MarvinBrth/ttsky25b-analog-opamp-rrio-cgm/docs/images/bias-supply.png

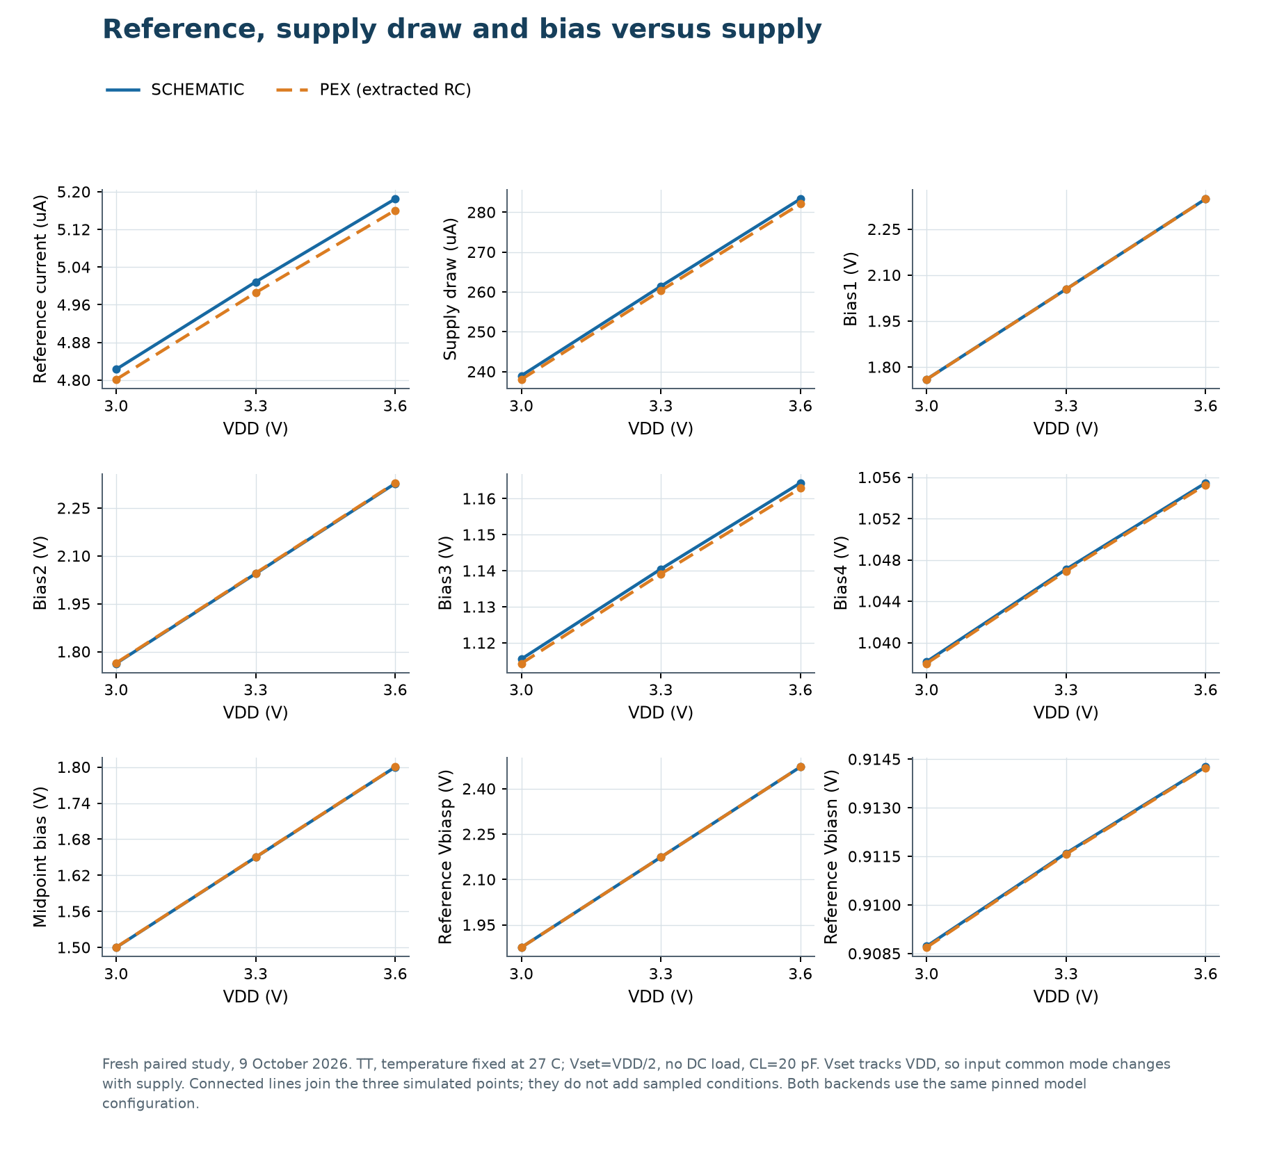
docs/images/bias-supply.png
