MarvinBrth/ttsky25b-analog-opamp-rrio-cgm/docs/images/bias-temperature.png

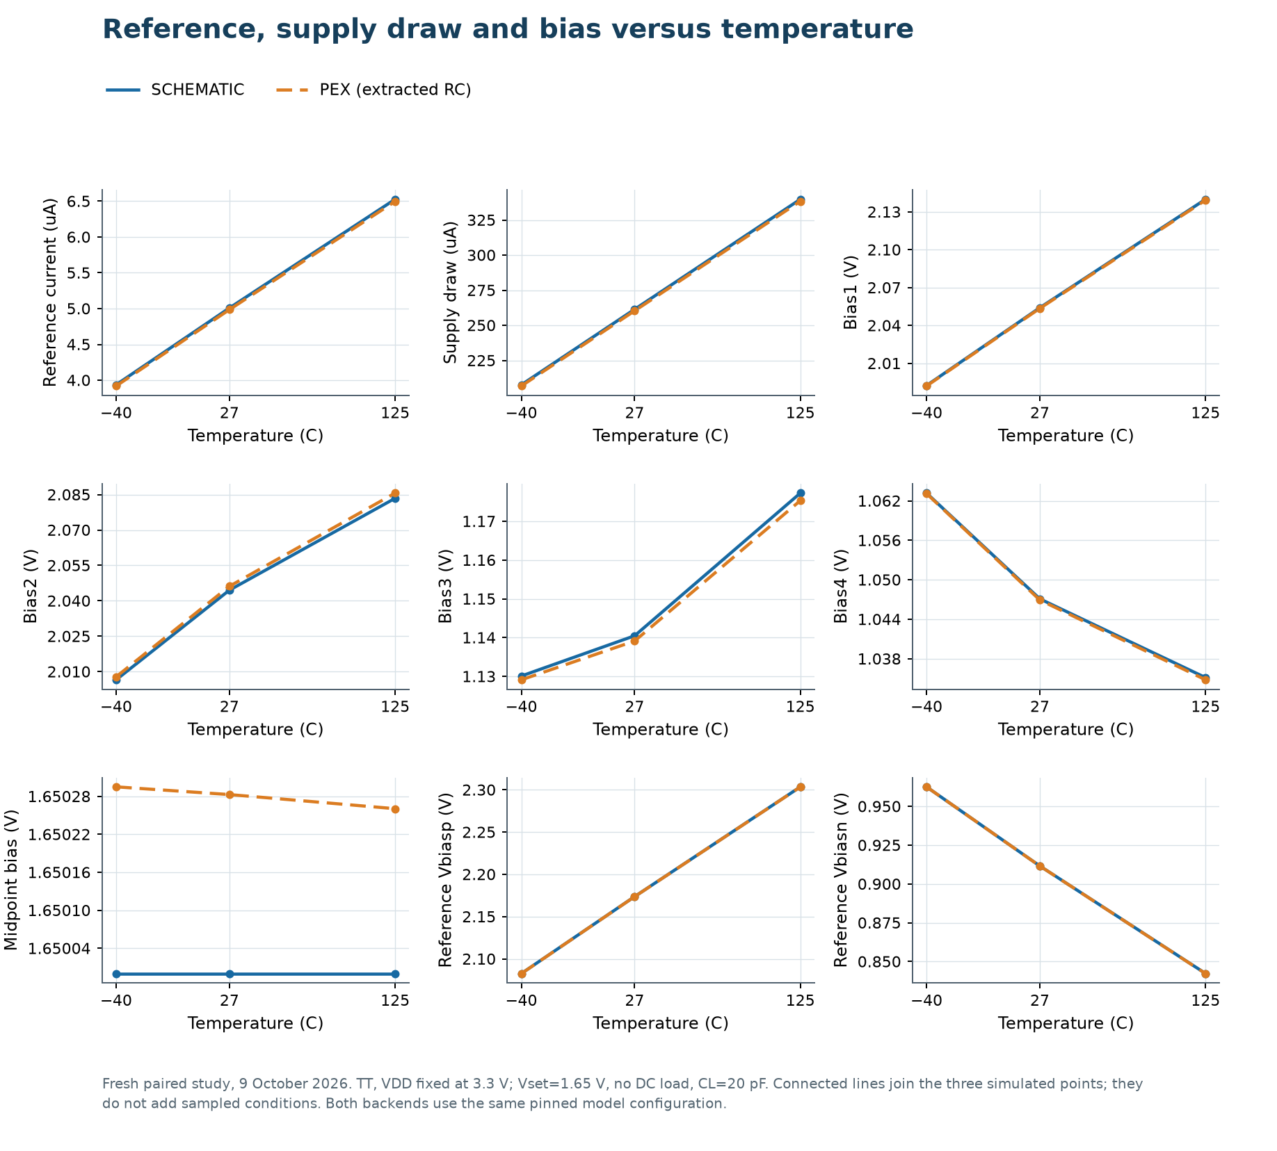
docs/images/bias-temperature.png
