MarvinBrth/ttsky25b-analog-opamp-rrio-cgm/docs/images/common-mode.png

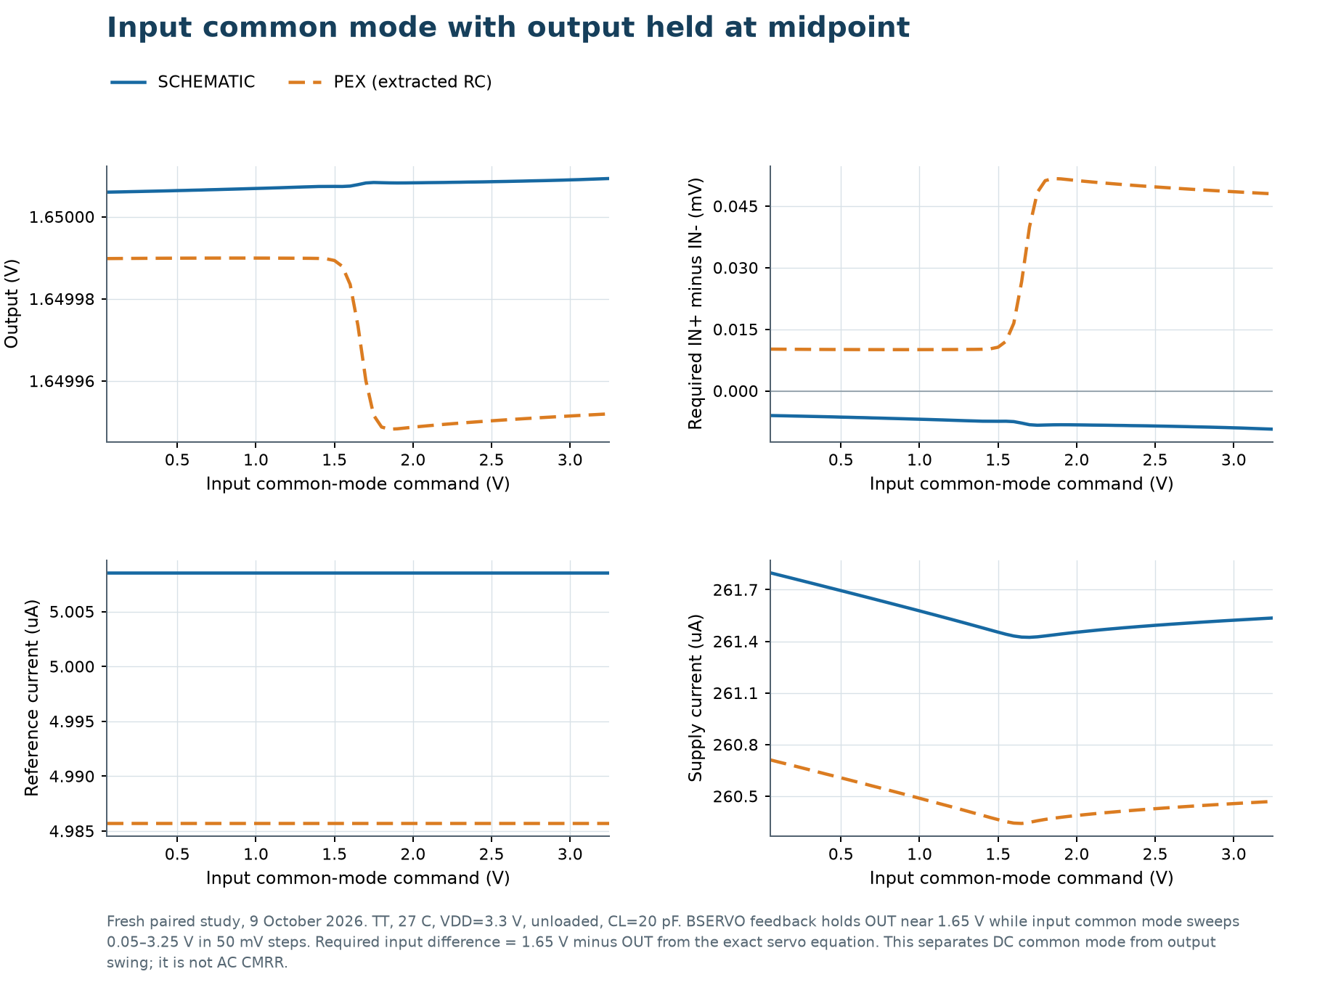
docs/images/common-mode.png
