MarvinBrth/ttsky25b-analog-opamp-rrio-cgm/docs/images/dc-transfer.png

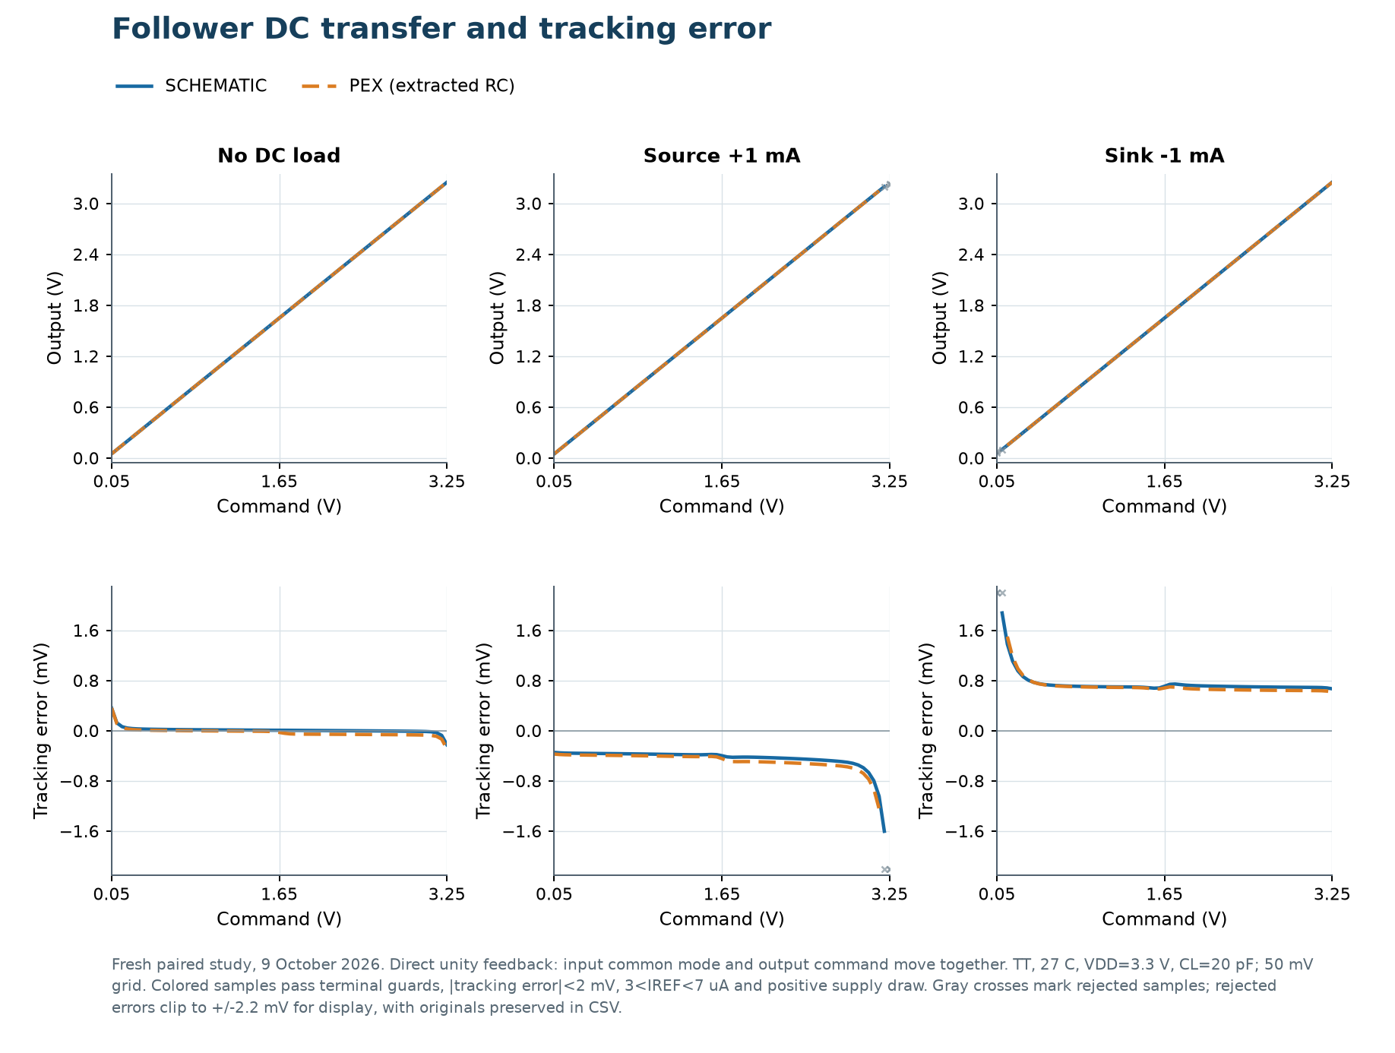
docs/images/dc-transfer.png
