MarvinBrth/ttsky25b-analog-opamp-rrio-cgm/docs/images/frequency-nominal.png

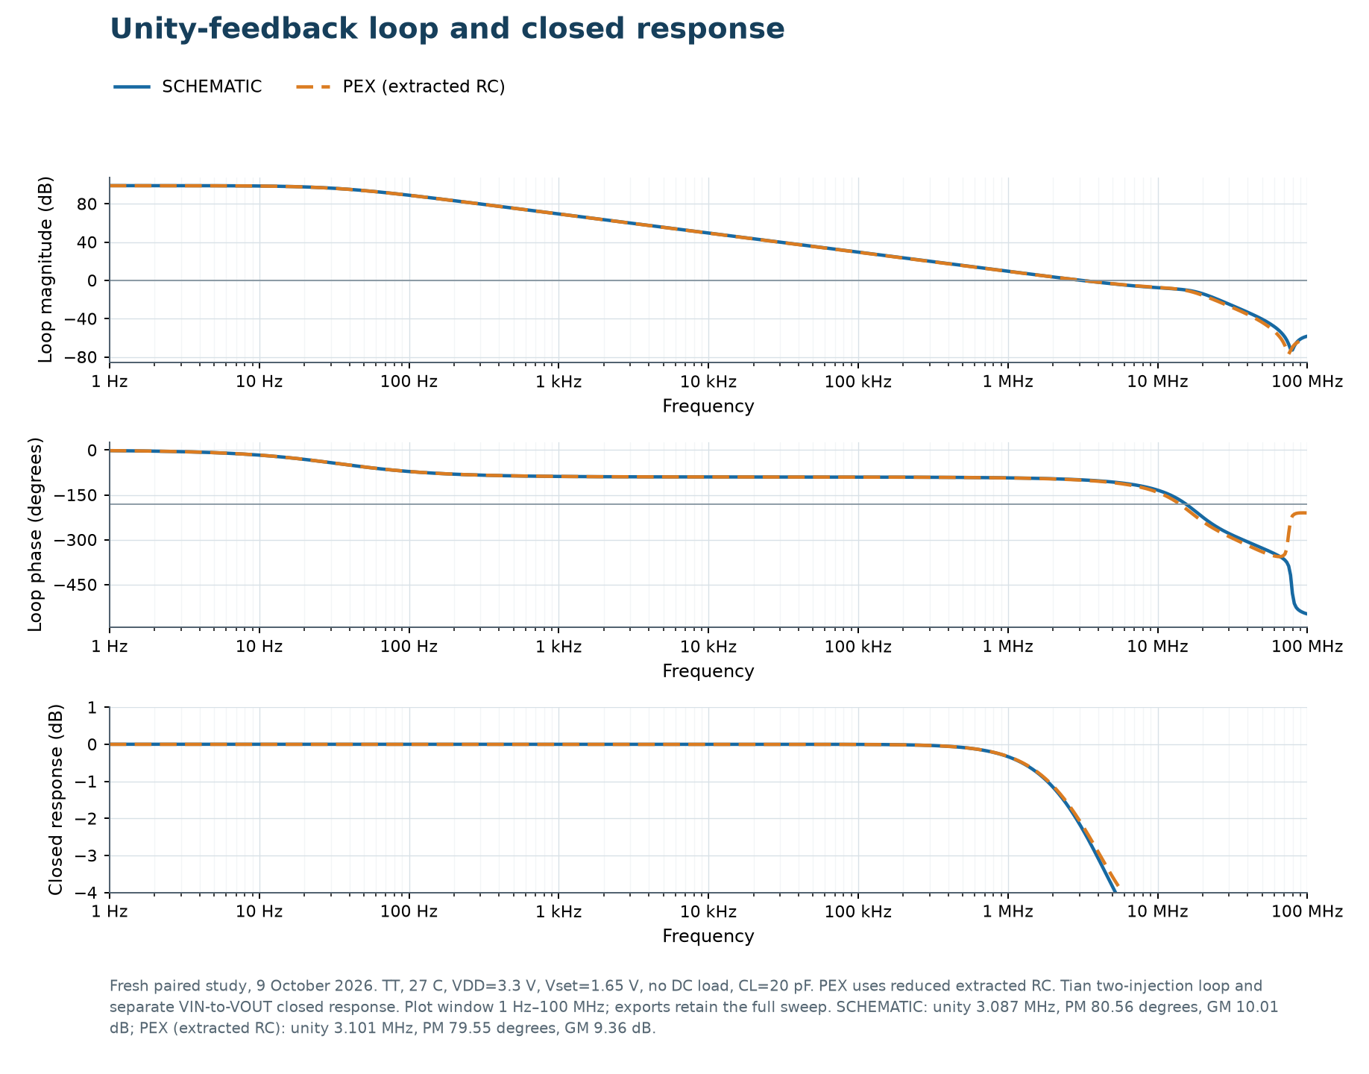
docs/images/frequency-nominal.png
