MarvinBrth/ttsky25b-analog-opamp-rrio-cgm/docs/images/frequency-supply.png

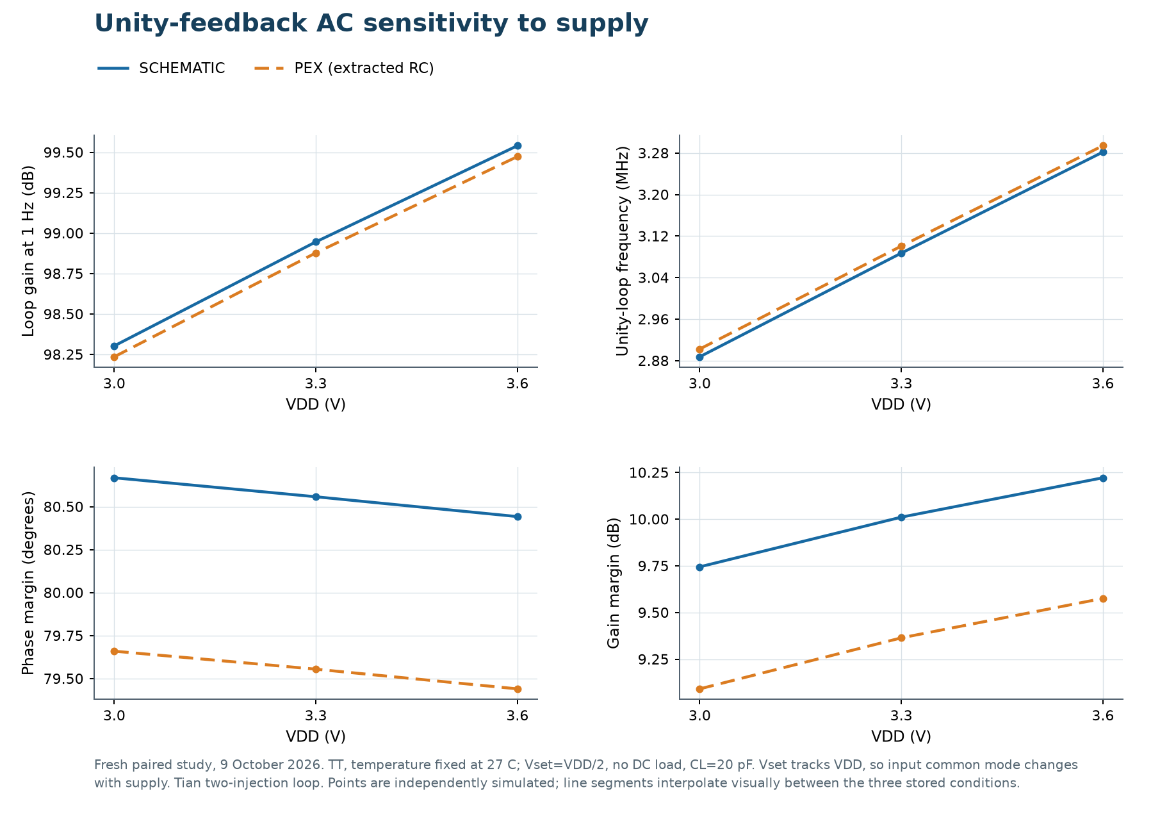
docs/images/frequency-supply.png
