MarvinBrth/ttsky25b-analog-opamp-rrio-cgm/docs/images/frequency-temperature.png

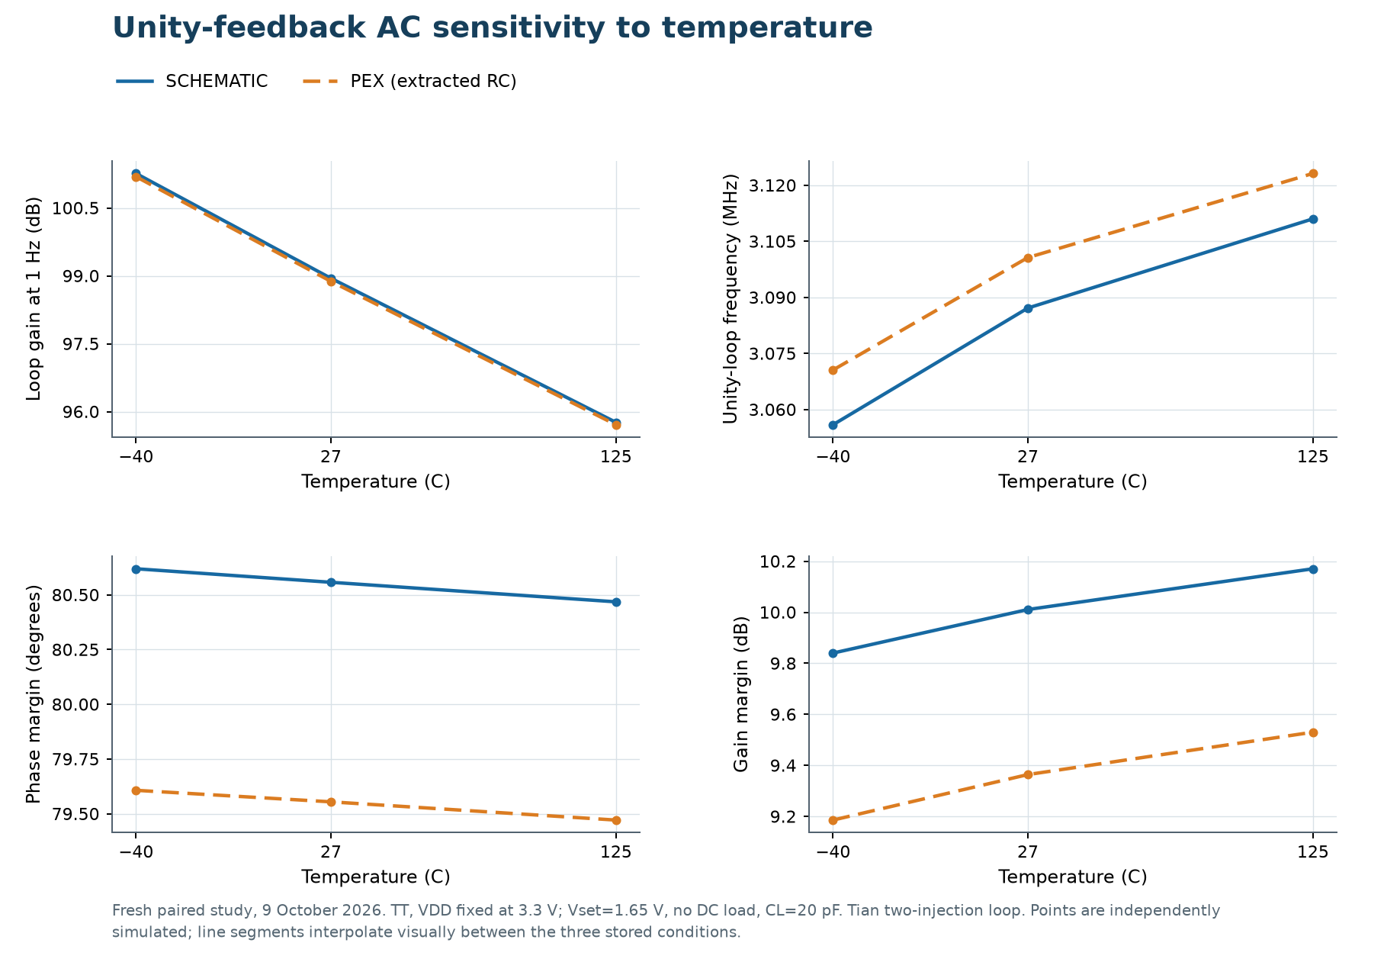
docs/images/frequency-temperature.png
