MarvinBrth/ttsky25b-analog-opamp-rrio-cgm/docs/images/reference-startup.png

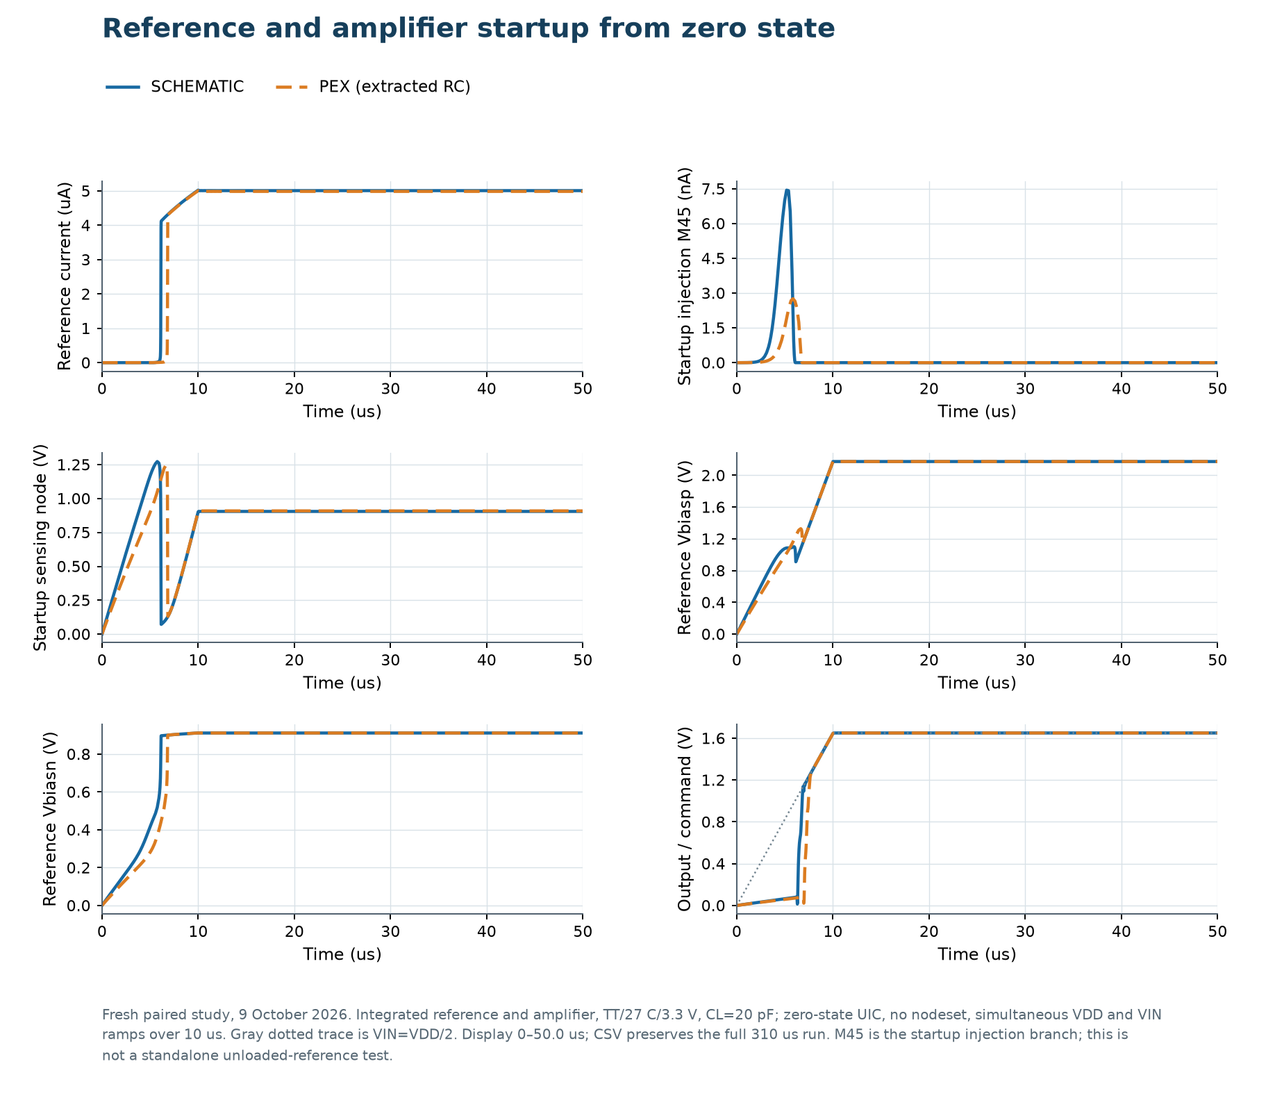
docs/images/reference-startup.png
