MarvinBrth/ttsky25b-analog-opamp-rrio-cgm/docs/images/load-step.png

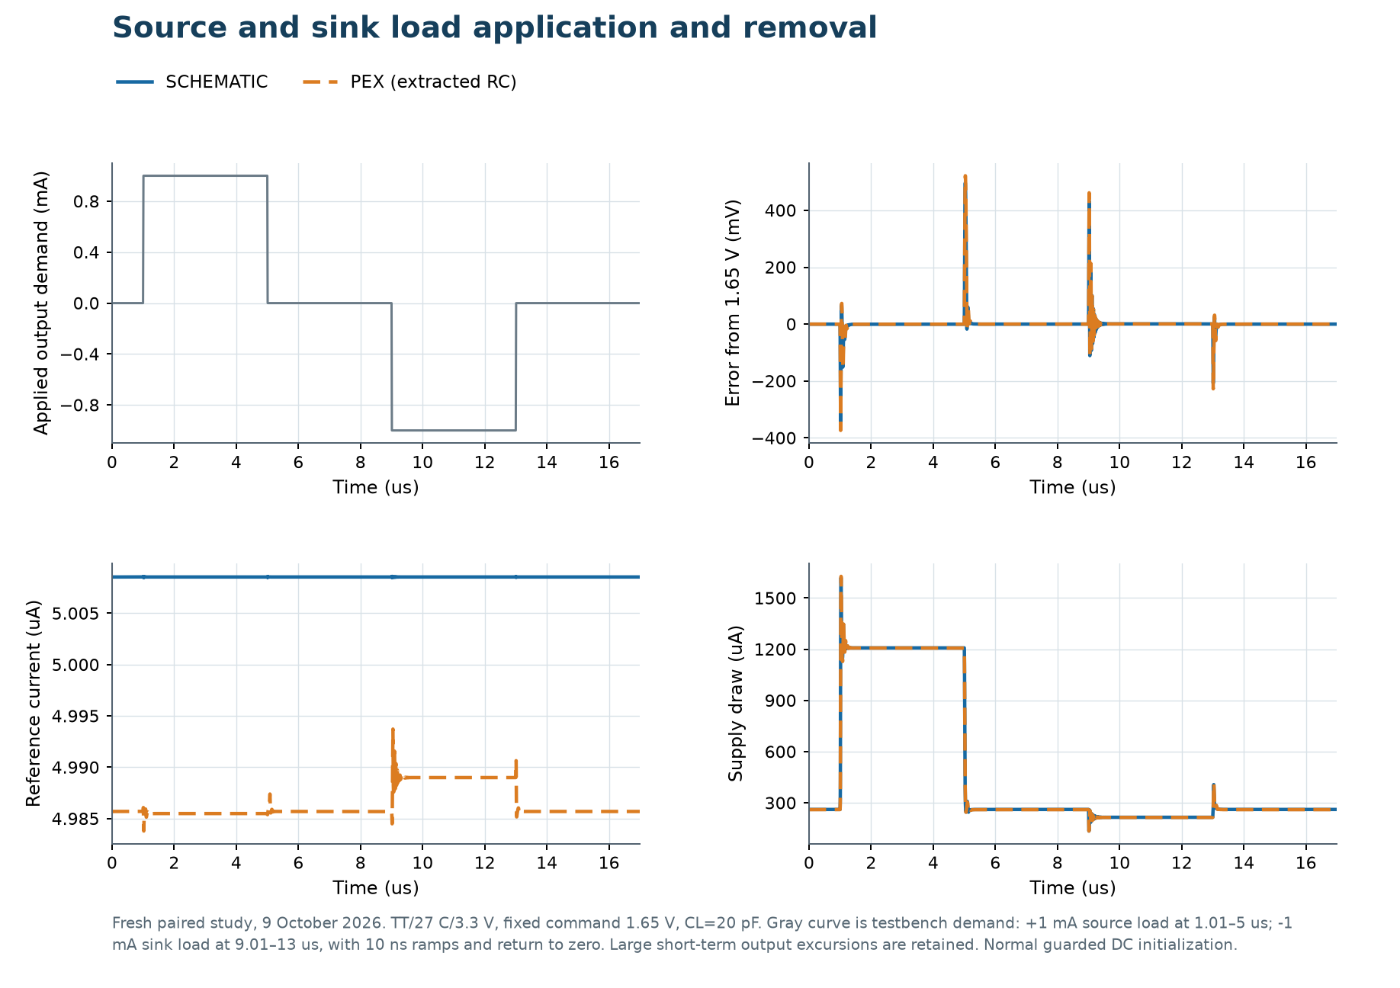
docs/images/load-step.png
