MarvinBrth/ttsky25b-analog-opamp-rrio-cgm/docs/images/signal-step.png

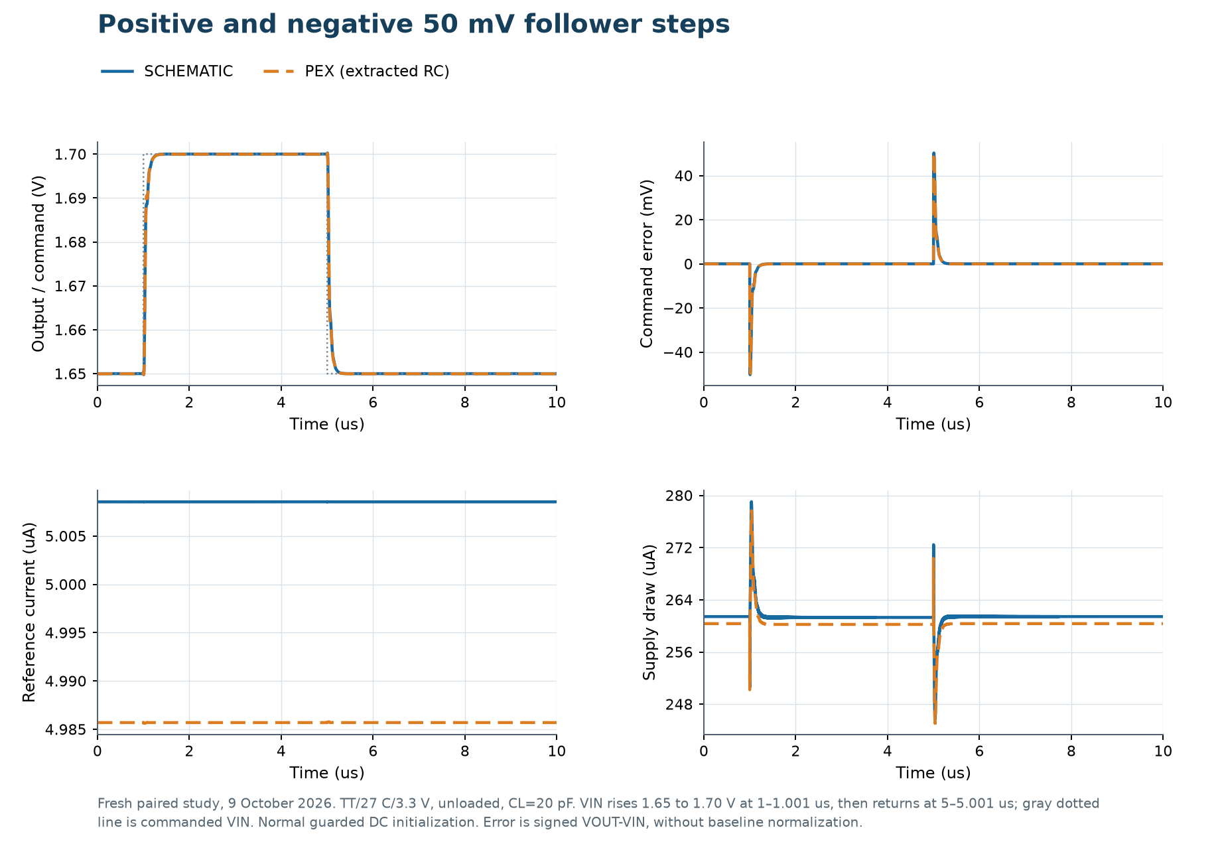
docs/images/signal-step.png
