MarvinBrth/ttsky25b-analog-opamp-rrio-cgm/docs/images/supply-step.png

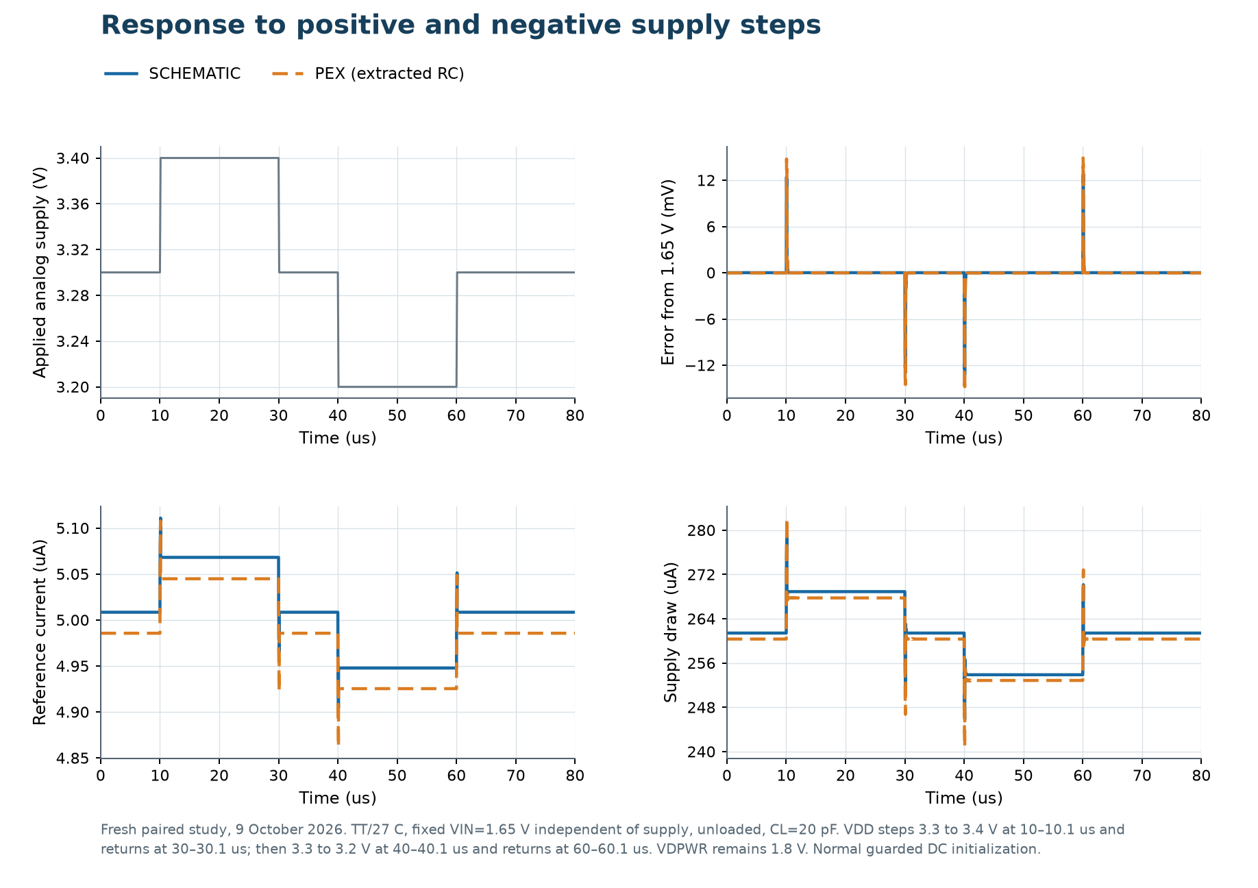
docs/images/supply-step.png
