MarvinBrth/ttsky25b-analog-opamp-rrio-cgm/docs/data/characterization/bias-supply-pex.csv

VDD | IREF_uA | supply_uA | bias1_V | bias2_V | bias3_V | bias4_V | midpoint_bias_V | Vbiasp_V | Vbiasn_V | Vstartup_V
3 | 4.8013172499091477 | 238.01926666482009 | 1.7594787045567419 | 1.764508311142795 | 1.114306179147847 | 1.0379873590722839 | 1.5002583827582769 | 1.8753874850060239 | 0.90868936878876505 | 0.6567920098064729
3.2999999999999998 | 4.9856953519447504 | 260.33177297180094 | 2.053539552721011 | 2.0461697051041958 | 1.1391261065509559 | 1.046923925965966 | 1.6502828299963259 | 2.1736308922570982 | 0.91156820613042866 | 0.90875607281831006
3.6000000000000001 | 5.1606812547610694 | 282.11443403591829 | 2.3480274607962759 | 2.328827070599615 | 1.1628571637849261 | 1.0552760972850479 | 1.800307285737613 | 2.47201066274561 | 0.9142356376531211 | 1.1662414705496329
