MarvinBrth/ttsky25b-analog-opamp-rrio-cgm/docs/data/characterization/bias-temperature-pex.csv

temp_C | IREF_uA | supply_uA | bias1_V | bias2_V | bias3_V | bias4_V | midpoint_bias_V | Vbiasp_V | Vbiasn_V | Vstartup_V
-40 | 3.9186957918337182 | 206.77969150656818 | 1.992027615236408 | 2.007817778279454 | 1.129117590999458 | 1.0631007487697119 | 1.6502950196888091 | 2.082577723366549 | 0.96258236408419895 | 1.1625035610861669
27 | 4.9856953519447504 | 260.33177297180094 | 2.053539552721011 | 2.0461697051041958 | 1.1391261065509559 | 1.046923925965966 | 1.6502828299963259 | 2.1736308922570982 | 0.91156820613042866 | 0.90875607281831006
125 | 6.4974124942563201 | 338.37208085374584 | 2.139267619894778 | 2.0856604352043568 | 1.175335882315792 | 1.034799729241423 | 1.650260503326894 | 2.3033933267129831 | 0.84223276038333472 | 0.54378225143768244
