MarvinBrth/ttsky25b-analog-opamp-rrio-cgm/docs/data/characterization/common-mode-pex-currents.csv

input_CM_command_V | Vout_V | I_VDD_A | IREF_A
0.050000000000000003 | 1.6499898187396751 | -0.00026071143480936479 | 4.9856944315366532e-06
0.10000000000000001 | 1.649989832123677 | -0.00026069964737871908 | 4.9856944315366532e-06
0.14999999999999999 | 1.64998984502014 | -0.0002606883844520001 | 4.9856944315366532e-06
0.20000000000000001 | 1.6499898572142391 | -0.0002606768317770158 | 4.9856944315366532e-06
0.25 | 1.649989868747346 | -0.00026066525970304481 | 4.9856944315366532e-06
0.29999999999999999 | 1.6499898795493519 | -0.0002606536671531042 | 4.9856944315366532e-06
0.34999999999999998 | 1.649989889597345 | -0.00026064205316987589 | 4.9856944315366532e-06
0.40000000000000002 | 1.6499898988626029 | -0.00026063014373436228 | 4.9856944315366532e-06
0.45000000000000001 | 1.6499899072844411 | -0.00026061875555853078 | 4.9856944315366532e-06
0.49999999999999989 | 1.649989914861034 | -0.00026060706939086192 | 4.9856944315366532e-06
0.54999999999999993 | 1.6499899215325089 | -0.00026059535612577342 | 4.9856944315366532e-06
0.59999999999999998 | 1.649989927292326 | -0.00026058361407466291 | 4.9856944315366532e-06
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
