MarvinBrth/ttsky25b-analog-opamp-rrio-cgm/docs/data/characterization/common-mode-pex.csv

input_CM_command_V | Vout_V | output_minus_midpoint_mV | input_differential_mV | qualified_flag
0.050000000000000003 | 1.64998981873968 | -0.010181260324815301 | 0.010181260324815301 | 1
0.10000000000000001 | 1.6499898321236799 | -0.0101678763229085 | 0.0101678763229085 | 1
0.14999999999999999 | 1.64998984502014 | -0.010154979859899899 | 0.010154979859899899 | 1
0.20000000000000001 | 1.64998985721424 | -0.010142785760836 | 0.010142785760836 | 1
0.25 | 1.64998986874735 | -0.010131252653922101 | 0.010131252653922101 | 1
0.29999999999999999 | 1.6499898795493499 | -0.0101204506479657 | 0.0101204506479657 | 1
0.34999999999999998 | 1.6499898895973499 | -0.010110402654861499 | 0.010110402654861499 | 1
0.40000000000000002 | 1.6499898988626001 | -0.010101137396967301 | 0.010101137396967301 | 1
0.45000000000000001 | 1.6499899072844399 | -0.0100927155588515 | 0.0100927155588515 | 1
0.5 | 1.64998991486103 | -0.010085138965942901 | 0.010085138965942901 | 1
0.55000000000000004 | 1.64998992153251 | -0.010078467491014801 | 0.010078467491014801 | 1
0.59999999999999998 | 1.64998992729233 | -0.0100727076739471 | 0.0100727076739471 | 1
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
