MarvinBrth/ttsky25b-analog-opamp-rrio-cgm/docs/data/characterization/dc-transfer-pex-no-currents.csv

command_V | Vout_V | I_VDD_A | IREF_A
0.050000000000000003 | 0.050363342036773028 | -0.00023010110790807291 | 4.9855602771439134e-06
0.10000000000000001 | 0.10011423707287589 | -0.00024110958447352431 | 4.9855602771439134e-06
0.14999999999999999 | 0.15005032187007719 | -0.00025113347656913329 | 4.9855602771439134e-06
0.20000000000000001 | 0.20002773007963659 | -0.00025662419993413121 | 4.9855602771439134e-06
0.25 | 0.25001830620068349 | -0.00025920312067044158 | 4.9855602771439134e-06
0.29999999999999999 | 0.30001356215709479 | -0.00026046148409055971 | 4.9855602771439134e-06
0.34999999999999998 | 0.3500106829608014 | -0.00026113873164998979 | 4.9855602771439134e-06
0.40000000000000002 | 0.40000866305566452 | -0.00026153535685771669 | 4.9855602771439134e-06
0.45000000000000001 | 0.45000709731631761 | -0.00026177983986773451 | 4.9855602771439134e-06
0.49999999999999989 | 0.50000580020236651 | -0.00026193288810050431 | 4.9855602771439134e-06
0.54999999999999993 | 0.55000467639050077 | -0.0002620261999391328 | 4.9855602771439134e-06
0.59999999999999998 | 0.60000367227505214 | -0.00026207782601447041 | 4.9855602771439134e-06
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
