MarvinBrth/ttsky25b-analog-opamp-rrio-cgm/docs/data/characterization/dc-transfer-pex-no.csv

command_V | Vout_V | error_mV | qualified_flag
0.050000000000000003 | 0.050363342036773 | 0.36334203677302501 | 1
0.10000000000000001 | 0.10011423707287601 | 0.114237072875889 | 1
0.14999999999999999 | 0.150050321870077 | 0.050321870077196802 | 1
0.20000000000000001 | 0.20002773007963701 | 0.027730079636578701 | 1
0.25 | 0.25001830620068299 | 0.018306200683493298 | 1
0.29999999999999999 | 0.30001356215709502 | 0.0135621570948041 | 1
0.34999999999999998 | 0.35001068296080101 | 0.0106829608014225 | 1
0.40000000000000002 | 0.40000866305566501 | 0.0086630556644928802 | 1
0.45000000000000001 | 0.45000709731631799 | 0.0070973163175946903 | 1
0.5 | 0.50000580020236696 | 0.0058002023666237097 | 1
0.55000000000000004 | 0.55000467639050099 | 0.0046763905008351302 | 1
0.59999999999999998 | 0.60000367227505202 | 0.0036722750521578401 | 1
0.65000000000000002 | 0.65000275505373994 | 0.0027550537394782598 | 1
0.69999999999999996 | 0.70000190338507196 | 0.0019033850719996099 | 1
0.75 | 0.75000110273009402 | 0.0011027300934607399 | 1
0.80000000000000004 | 0.80000034268088704 | 0.00034268088644484601 | 1
0.84999999999999998 | 0.849999615544343 | -0.00038445565686551198 | 1
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
