MarvinBrth/ttsky25b-analog-opamp-rrio-cgm/src/project.v

/*
 * Copyright (c) 2026 MarvinBrth
 * SPDX-License-Identifier: Apache-2.0
 */

`default_nettype none

module tt_um_marvinbrth_opamp_rrio_cgm_3v3 (
    input  wire       VGND,
    input  wire       VDPWR,    // 1.8v power supply
    input  wire       VAPWR,    // 3.3v power supply
    input  wire [7:0] ui_in,    // Dedicated inputs
    output wire [7:0] uo_out,   // Dedicated outputs
    input  wire [7:0] uio_in,   // IOs: Input path
    output wire [7:0] uio_out,  // IOs: Output path
    output wire [7:0] uio_oe,   // IOs: Enable path (active high: 0=input, 1=output)
    inout  wire [7:0] ua,       // Analog pins, only ua[5:0] can be used
    input  wire       ena,      // always 1 when the design is powered, so you can ignore it
    input  wire       clk,      // clock
    input  wire       rst_n     // reset_n - low to reset
);

opamp_rrio_cgm_3v3 XOP (
    .VAPWR(VAPWR),
    .diffout(ua[2]),
    .IN_P(ua[0]),
    .IN_N(ua[1]),
    .VGND(VGND)
);

assign uo_out[0] = VGND;
assign uo_out[1] = VGND;
assign uo_out[2] = VGND;
assign uo_out[3] = VGND;
assign uo_out[4] = VGND;
assign uo_out[5] = VGND;
assign uo_out[6] = VGND;
assign uo_out[7] = VGND;
assign uio_out[0] = VGND;
assign uio_out[1] = VGND;
assign uio_out[2] = VGND;
assign uio_out[3] = VGND;
assign uio_out[4] = VGND;
assign uio_out[5] = VGND;
assign uio_out[6] = VGND;
assign uio_out[7] = VGND;
assign uio_oe[0] = VGND;
assign uio_oe[1] = VGND;
assign uio_oe[2] = VGND;
assign uio_oe[3] = VGND;
assign uio_oe[4] = VGND;
assign uio_oe[5] = VGND;
assign uio_oe[6] = VGND;
assign uio_oe[7] = VGND;

endmodule
