MarvinBrth/ttsky25b-analog-opamp-rrio-cgm/(commit log)

2025-10-17 add xschem circuit files
    [opamp-rrio-cgm.sch]
2025-10-18 Debug Version
    [opamp-rrio-cgm.sch, testbench.sch]
2025-11-04 Tran good AC bad
    [Rod_Design.sch, opamp-rrio-cgm.sch, testbench.sch, testbench_ac.sch, testbench_tran.sch]
2026-10-06 Prepare self-biased 3.3 V op amp for TTSKY26d
    [opamp-rrio-cgm-3v3.sch, opamp_bias_3v3.sch, reference_bias_3v3.sch, testbench_ac_3v3.sch, testbench_bias_3v3.sch, testbench_loop_3v3.sch, testbench_output_dc_3v3.sch, testbench_output_tran_3v3.sch]
2026-10-06 Refine schematic wiring and KIT artwork
    [opamp-rrio-cgm-3v3.sch, testbench_output_dc_3v3.sch, testbench_output_tran_3v3.sch]
2026-10-08 Remove obsolete designs and keep essential project documentation
    [Rod_Design.sch, opamp-rrio-cgm.sch, testbench_ac.sch, testbench_tran.sch]
2026-10-08 Document amplifier architecture, bias, layout and verification
    [asw_ss_cold_high_source-loop.csv, asw_ss_cold_mid_sink-loop.csv, core-cases.csv, dynamic-cases.csv, interface-cases.csv, r500_ss_cold_mid_0-loop.csv, r500_ss_hot_mid_0-loop.csv, ss-cold-worst-gm-loop.csv]
2026-10-08 Normalize verification data line endings
    [asw_ss_cold_high_source-loop.csv, asw_ss_cold_mid_sink-loop.csv, core-cases.csv, dynamic-cases.csv, interface-cases.csv, r500_ss_cold_mid_0-loop.csv, r500_ss_hot_mid_0-loop.csv, ss-cold-worst-gm-loop.csv]
2026-10-09 Consolidate electrical report with schematic and layout comparisons
    [bias-supply-pex.csv, bias-supply-schematic.csv, bias-temperature-pex.csv, bias-temperature-schematic.csv, common-mode-pex-currents.csv, common-mode-pex.csv, common-mode-schematic-currents.csv, common-mode-schematic.csv]
2026-10-09 Explain reference sizing and amplifier behavior with simulation comparisons
    [drive_schematic_sink.csv, drive_schematic_source.csv, drive_small_output_sink.csv, drive_small_output_source.csv, frequency_ideal_bias_teaching_aol.csv, frequency_no_compensation_teaching_loop.csv, frequency_pex_cool_aol.csv, frequency_pex_cool_closed.csv]
2026-10-09 docs: show native Xschem simulation testbenches
    [bench-commonmode.sch, bench-follower.sch, bench-loop.sch, bench-open.sch]
